matysko1133/vrs_assignment_intelligent_garage/images/pinout_garage.png

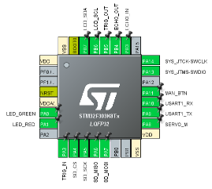
images/pinout_garage.png
