matysko1133/vrs_assignment_intelligent_garage/images/pinout_display.png

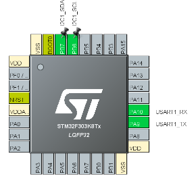
images/pinout_display.png
