matysko1133/vrs_assignment_intelligent_garage/garage_uart_sender/Core/Inc/i2c.h

/* i2c.h */
#ifndef __I2C_H__
#define __I2C_H__

#ifdef __cplusplus
extern "C" {
#endif

#include "main.h"

extern I2C_HandleTypeDef hi2c1;

void MX_I2C1_Init(void);

#ifdef __cplusplus
}
#endif

#endif
