matysko1133/vrs_assignment_intelligent_garage/garage_uart_sender/Core/Inc/spi.h

/* spi.h */
#ifndef __SPI_H__
#define __SPI_H__

#ifdef __cplusplus
extern "C" {
#endif

#include "main.h"

extern SPI_HandleTypeDef hspi1;

void MX_SPI1_Init(void);

#ifdef __cplusplus
}
#endif

#endif
