matysko1133/vrs_assignment_intelligent_garage/garage_uart_sender/Core/Inc/usart.h

/* usart.h */
#ifndef __USART_H__
#define __USART_H__

#ifdef __cplusplus
extern "C" {
#endif

#include "main.h"

extern UART_HandleTypeDef huart1;

void MX_USART1_UART_Init(void);

#ifdef __cplusplus
}
#endif

#endif
