matysko1133/vrs_assignment_intelligent_garage/(commit log)

2026-01-08 add circuit diagram
2026-01-08 add circuit diagram and board config
